iezqrom/publication-cold-sensation-without-touch/figures/figure1/panelE_thermalImage.png

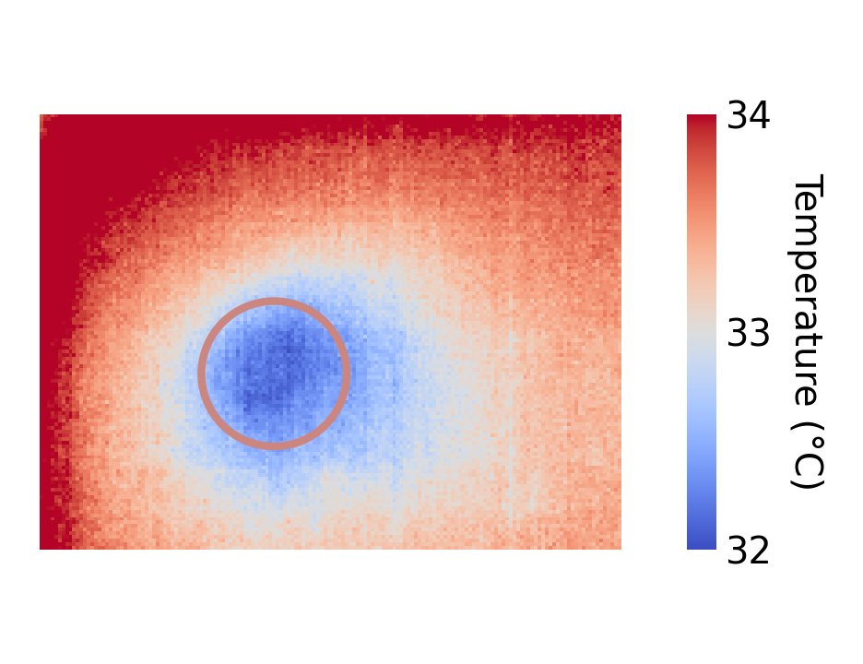
figures/figure1/panelE_thermalImage.png
