iezqrom/publication-cold-sensation-without-touch/README.md

# A novel method to selectively elicit cold sensations without touch :snowflake::cold_face::call_me_hand:
[Version in Journal of Methods Neuroscience](https://www.sciencedirect.com/science/article/pii/S0165027022002898)

Versions in Biorxiv: [v1](https://www.biorxiv.org/content/10.1101/2022.06.14.496120v1), [v2](https://www.biorxiv.org/content/10.1101/2022.06.14.496120v2) & [v3](https://www.biorxiv.org/content/10.1101/2022.06.14.496120v3)

The data can be found in the following [OSF repository](https://osf.io/s3ta8/).

## Highlights :star::zap:
- Most studies on cold sensation fail to control for concomitant tactile input.
- A method to deliver non-tactile cooling stimuli was developed.
- The method combines dry ice, a thermal camera, and motorised stages.
- The method delivers rapid ramps and feedback-controlled pulses.
- Thresholds for contactless cold perception were estimated in humans

## Abstract :page_with_curl:
### Background
Thermal and tactile stimuli are transduced by different receptor classes. However, mechano- and thermo-sensitive afferents interact at spinal and supraspinal levels. Yet, most studies on responses to cooling stimuli are confounded by mechanical contact, making these interactions difficult to isolate. Methods for precise control of non-mechanical thermal stimulations remain challenging, particularly in the cold range.

### New Method
We developed a non-tactile, focal, temperature-controlled, multi-purpose cooling stimulator. This method controls the exposure of a target skin region to a dry-ice source. Using a thermal camera to monitor skin temperature, and adjusting the source-skin distance accordingly, we could deliver non-tactile cooling stimuli with customisable profiles, for studying different aspects of cold sensation.

### Results
To validate our method, we measured absolute and relative thresholds for cold sensation without mechanical contact in 13 human volunteer participants, using the method of limits. We found that the absolute cold detection threshold was 32.71 oC ± 0.88 oC. This corresponded to a threshold relative to each participant’s baseline skin temperature of -1.08 oC ± 0.37 oC.

### Comparisons with Existing Method
Our method allows cooling stimulation without the confound of mechanical contact, in a controllable and focal manner.

### Conclusions
We report a non-contact cooling stimulator and accompanying control system. We used this to measure cold thresholds in the absence of confounding touch. Our method enables more targeted studies of both cold sensory pathways, and of cold-touch interactions.

## Authors :man_scientist::woman_scientist:
- Ivan Ezquerra-Romano
- Maansib Chowdhury
- Caterina Maria Leone
- Gian Domenico Iannetti
- Patrick Haggard

:key: **Keywords:** Thermoception, Perception, Sensation, Temperature, Mechanosensation, Cold

### Environment :computer::floppy_disk:
- Devices: MacBook Pro (13-inch, 2019, Two Thunderbolt 3 ports) & Arduino Uno
- Operating system: macOS Monterey Version 12.4
- Programming languages: Python 3.8.6 & Arduino 1.8.19
