iezqrom/publication-cold-sensation-without-touch/figures/appendixA/appendixA_drop_analysis.png

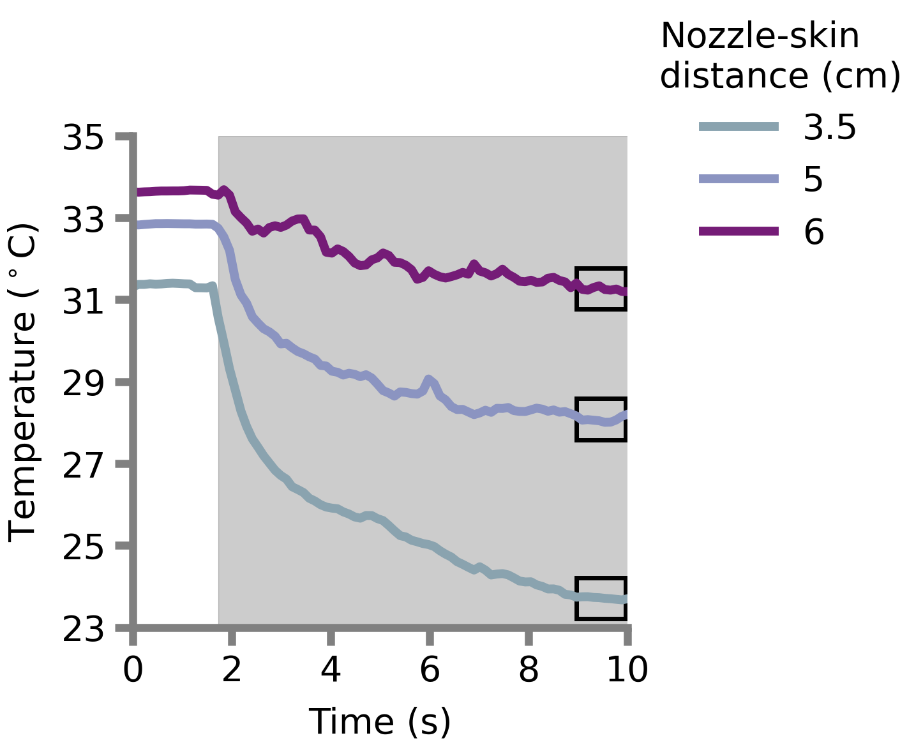
figures/appendixA/appendixA_drop_analysis.png
