iezqrom/publication-cold-sensation-without-touch/figures/appendixA/appendixA_linear_regression.png

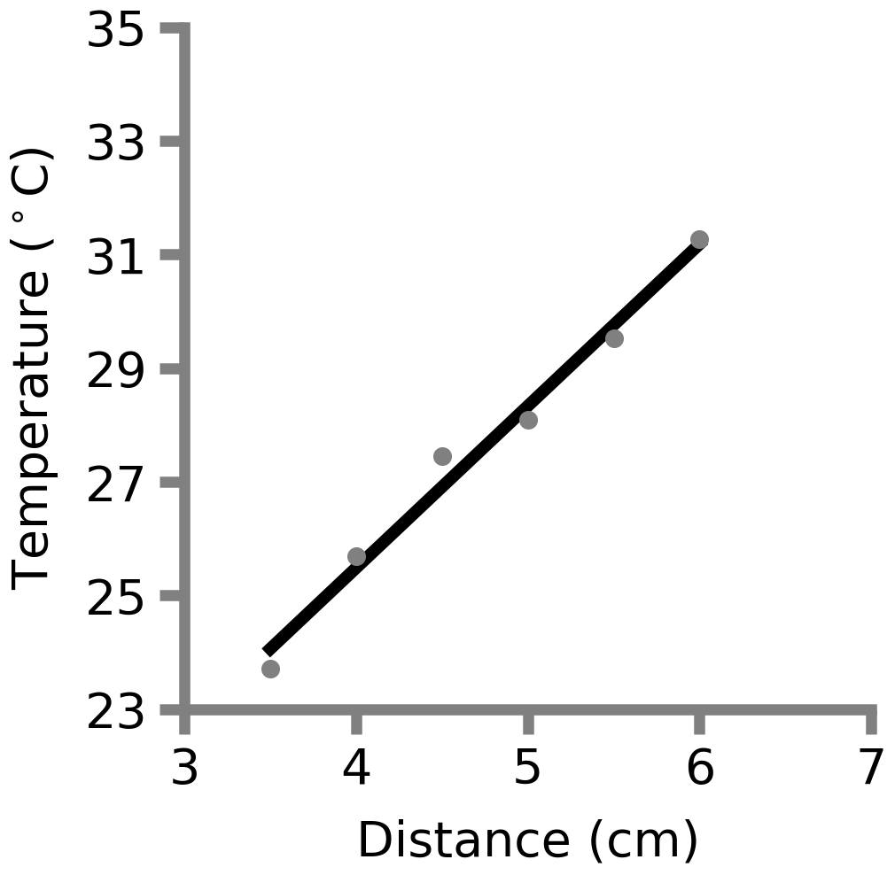
figures/appendixA/appendixA_linear_regression.png
