iezqrom/publication-cold-sensation-without-touch/figures/figure1/panelB_MOLexample.png

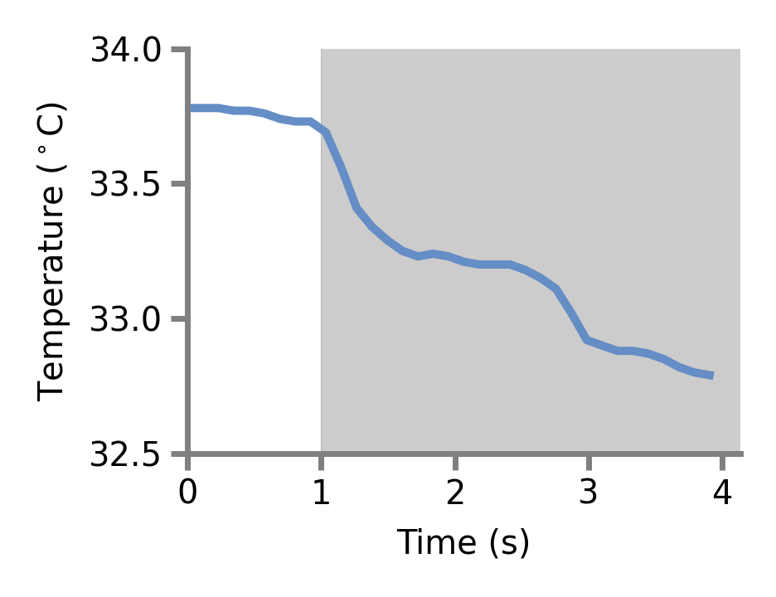
figures/figure1/panelB_MOLexample.png
