iezqrom/publication-cold-sensation-without-touch/figures/figure1/panelC_scenario2.png

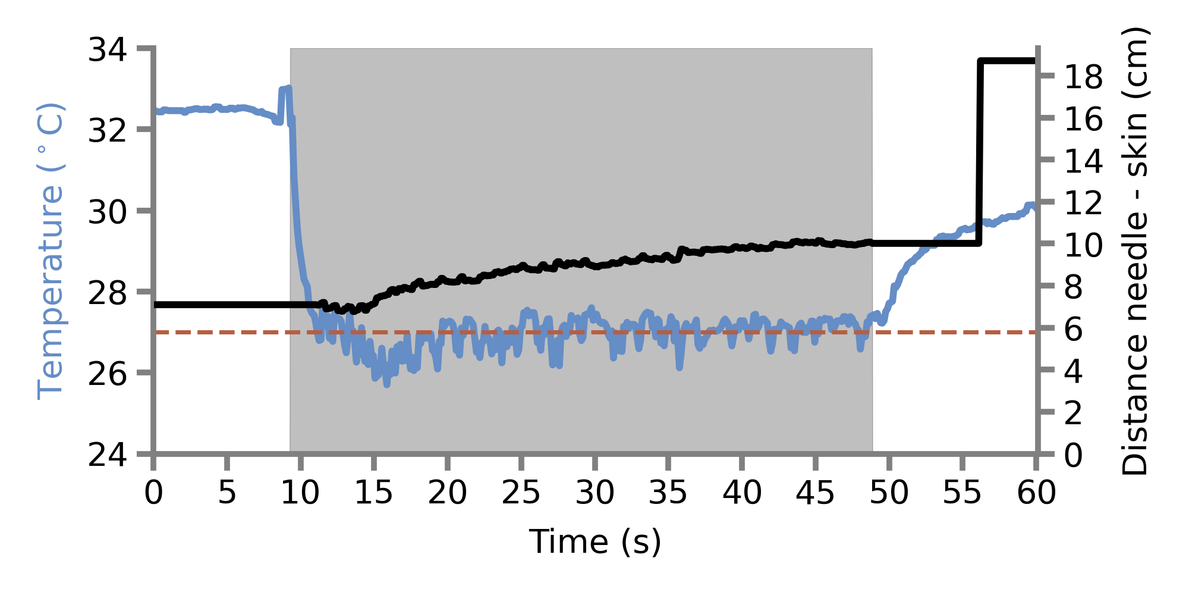
figures/figure1/panelC_scenario2.png
