iezqrom/publication-cold-sensation-without-touch/figures/figure1/panelC_scenario2_with_examplerobot.png

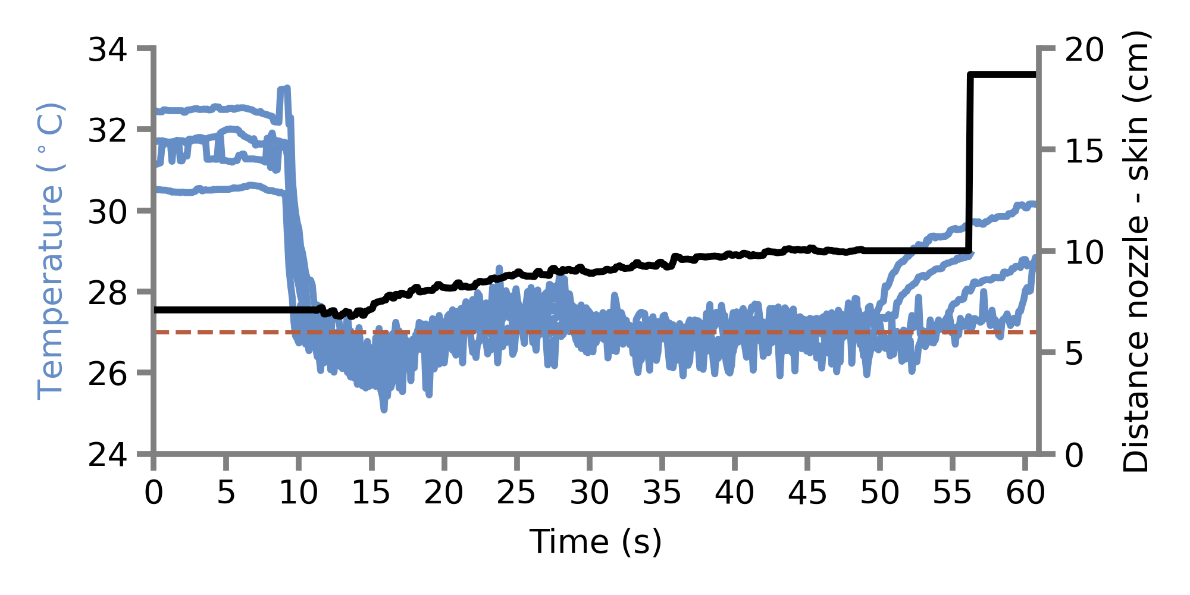
figures/figure1/panelC_scenario2_with_examplerobot.png
