iezqrom/publication-cold-sensation-without-touch/figures/figure1/panelD_scenario3.png

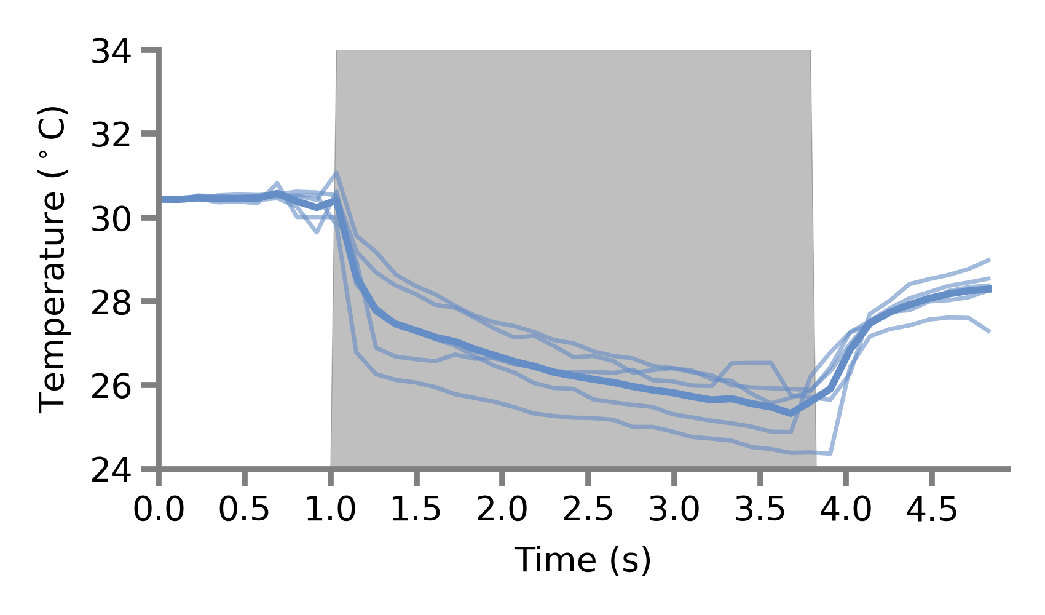
figures/figure1/panelD_scenario3.png
