iezqrom/publication-cold-sensation-without-touch/figures/figure1/panelF_deltas.png

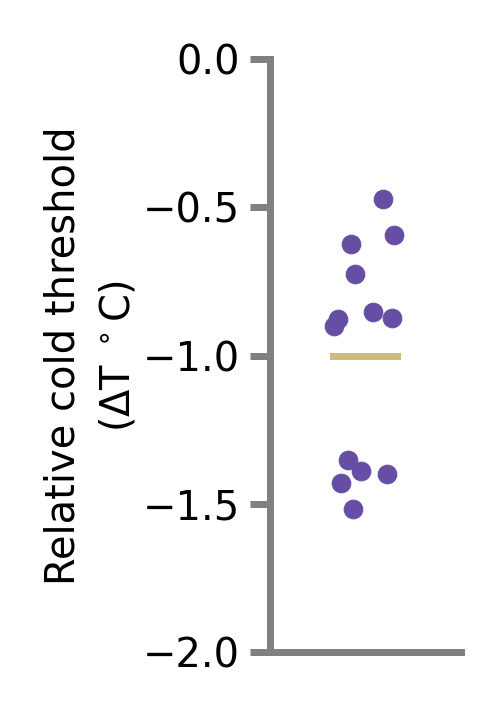
figures/figure1/panelF_deltas.png
