iezqrom/publication-cold-sensation-without-touch/code/data-collection/python/src_testing/methods_of_limits/tests/aa1.csv

tactile.experimental | tactile.experimental | tactile.control | tactile.control | non_tactile.experimental | non_tactile.experimental | non_tactile.control | non_tactile.control
rt | temperature | rt | temperature | rt | temperature | rt | temperature
3.5880329608917236 | 19.37 | 4.544689178466797 | 19.12 | 3.8581159114837646 | 19.91 | 5.497995853424072 | 18.47
2.7465929985046387 | 19.18 | 5.061499834060669 | 19.7 | 2.4719009399414062 | 19.19 | 4.9583899974823 | 18.15
