iezqrom/publication-cold-sensation-without-touch/code/data-collection/python/src_testing/methods_of_limits/tests/m1.csv

rt | temperature | cond
2.461475133895874 | 33.15 | 0
51.842854261398315 | 31.09 | 1
7.73470401763916 | 32.65 | 2
5.683874845504761 | 32.75 | 3
