iezqrom/publication-cold-sensation-without-touch/code/data-collection/python/src_testing/methods_of_limits/tests/m2_1.csv

rt | temperature | cond
67.68999696 | 28.63 | 1
44.67352509 | 28.6 | 0
9.641402006 | 30.46 | 0
52.60726595 | 28.93 | 1
41.24323106 | 30.99 | 0
34.86690378 | 30.4 | 1
2.972933054 | 32.33 | 1
24.355371 | 30.29 | 1
9.683411121 | 31.74 | 0
37.73239613 | 29.54 | 0
6.636884928 | 31.22 | 0
9.845098019 | 31.45 | 0
3.235290051 | 32.36 | 1
19.44264293 | 31.31 | 0
59.56136703 | 30.2 | 1
66.57432008 | 30.36 | 0
102.3292181 | 30.49 | 1
8.389775991 | 31.39 | 1
6.693963051 | 32.27 | 0
43.60876703 | 29.27 | 1
