iezqrom/publication-cold-sensation-without-touch/code/data-collection/arduino/dimmer_python_controlled/dimmer_python_controlled.ino

int AC_LOAD = 3;    // Output to Opto Triac pin
int dimming = 128;  // Dimming level (0-128)  0 = ON, 128 = OFF
int state;

void setup()
{
  Serial.begin(9600);
  pinMode(AC_LOAD, OUTPUT);// Set AC Load pin as output
  attachInterrupt(0, zero_crosss_int, FALLING);  // Choose the zero cross interrupt # from the table above
  dimming = 128;
}

//the interrupt function must take no parameters and return nothing
void zero_crosss_int()  //function to be fired at the zero crossing to dim the light
{
  // Firing angle calculation : 1 full 50Hz wave =1/50=20ms 
  // Every zerocrossing thus: (50Hz)-> 10ms (1/2 Cycle) 
  // For 60Hz => 8.33ms (10.000/120)
  // 10ms=10000us
  // (10000us - 10us) / 128 = 75 (Approx) For 60Hz =>65

  int dimtime = (65 * dimming);    // For 60Hz =>65    
  delayMicroseconds(dimtime);    // Wait till firing the TRIAC    
  digitalWrite(AC_LOAD, HIGH);   // Fire the TRIAC
  delayMicroseconds(8.33);         // triac On propogation delay 
         // (for 60Hz use 8.33) Some Triacs need a longer period
  digitalWrite(AC_LOAD, LOW);    // No longer trigger the TRIAC (the next zero crossing will swith it off) TRIAC
}

void loop()  {
  if(Serial.available()){
    state = Serial.read();
    Serial.println(state);
    delay(10);
    if (state == 0){
      dimming = 128;
      delay(10);
    }else if (state == 1){ 
      dimming = 80;
      delay(10);
      }
    }
  }
