iezqrom/publication-cold-sensation-without-touch/(commit log)

2022-10-24 arduino read me
2022-10-24 sentence readme arduino
2023-01-02 python code mol and other tests
    [aa1.csv, m1.csv, m2.csv, m2_1.csv]
